j3qq4hch/kotleta/README.md

# kotleta
[3d view](https://a360.co/2SrLnso)
