j3qq4hch/kotleta/KOTLETA.brd

## EAGLE design KOTLETA.brd (2019-02-04)

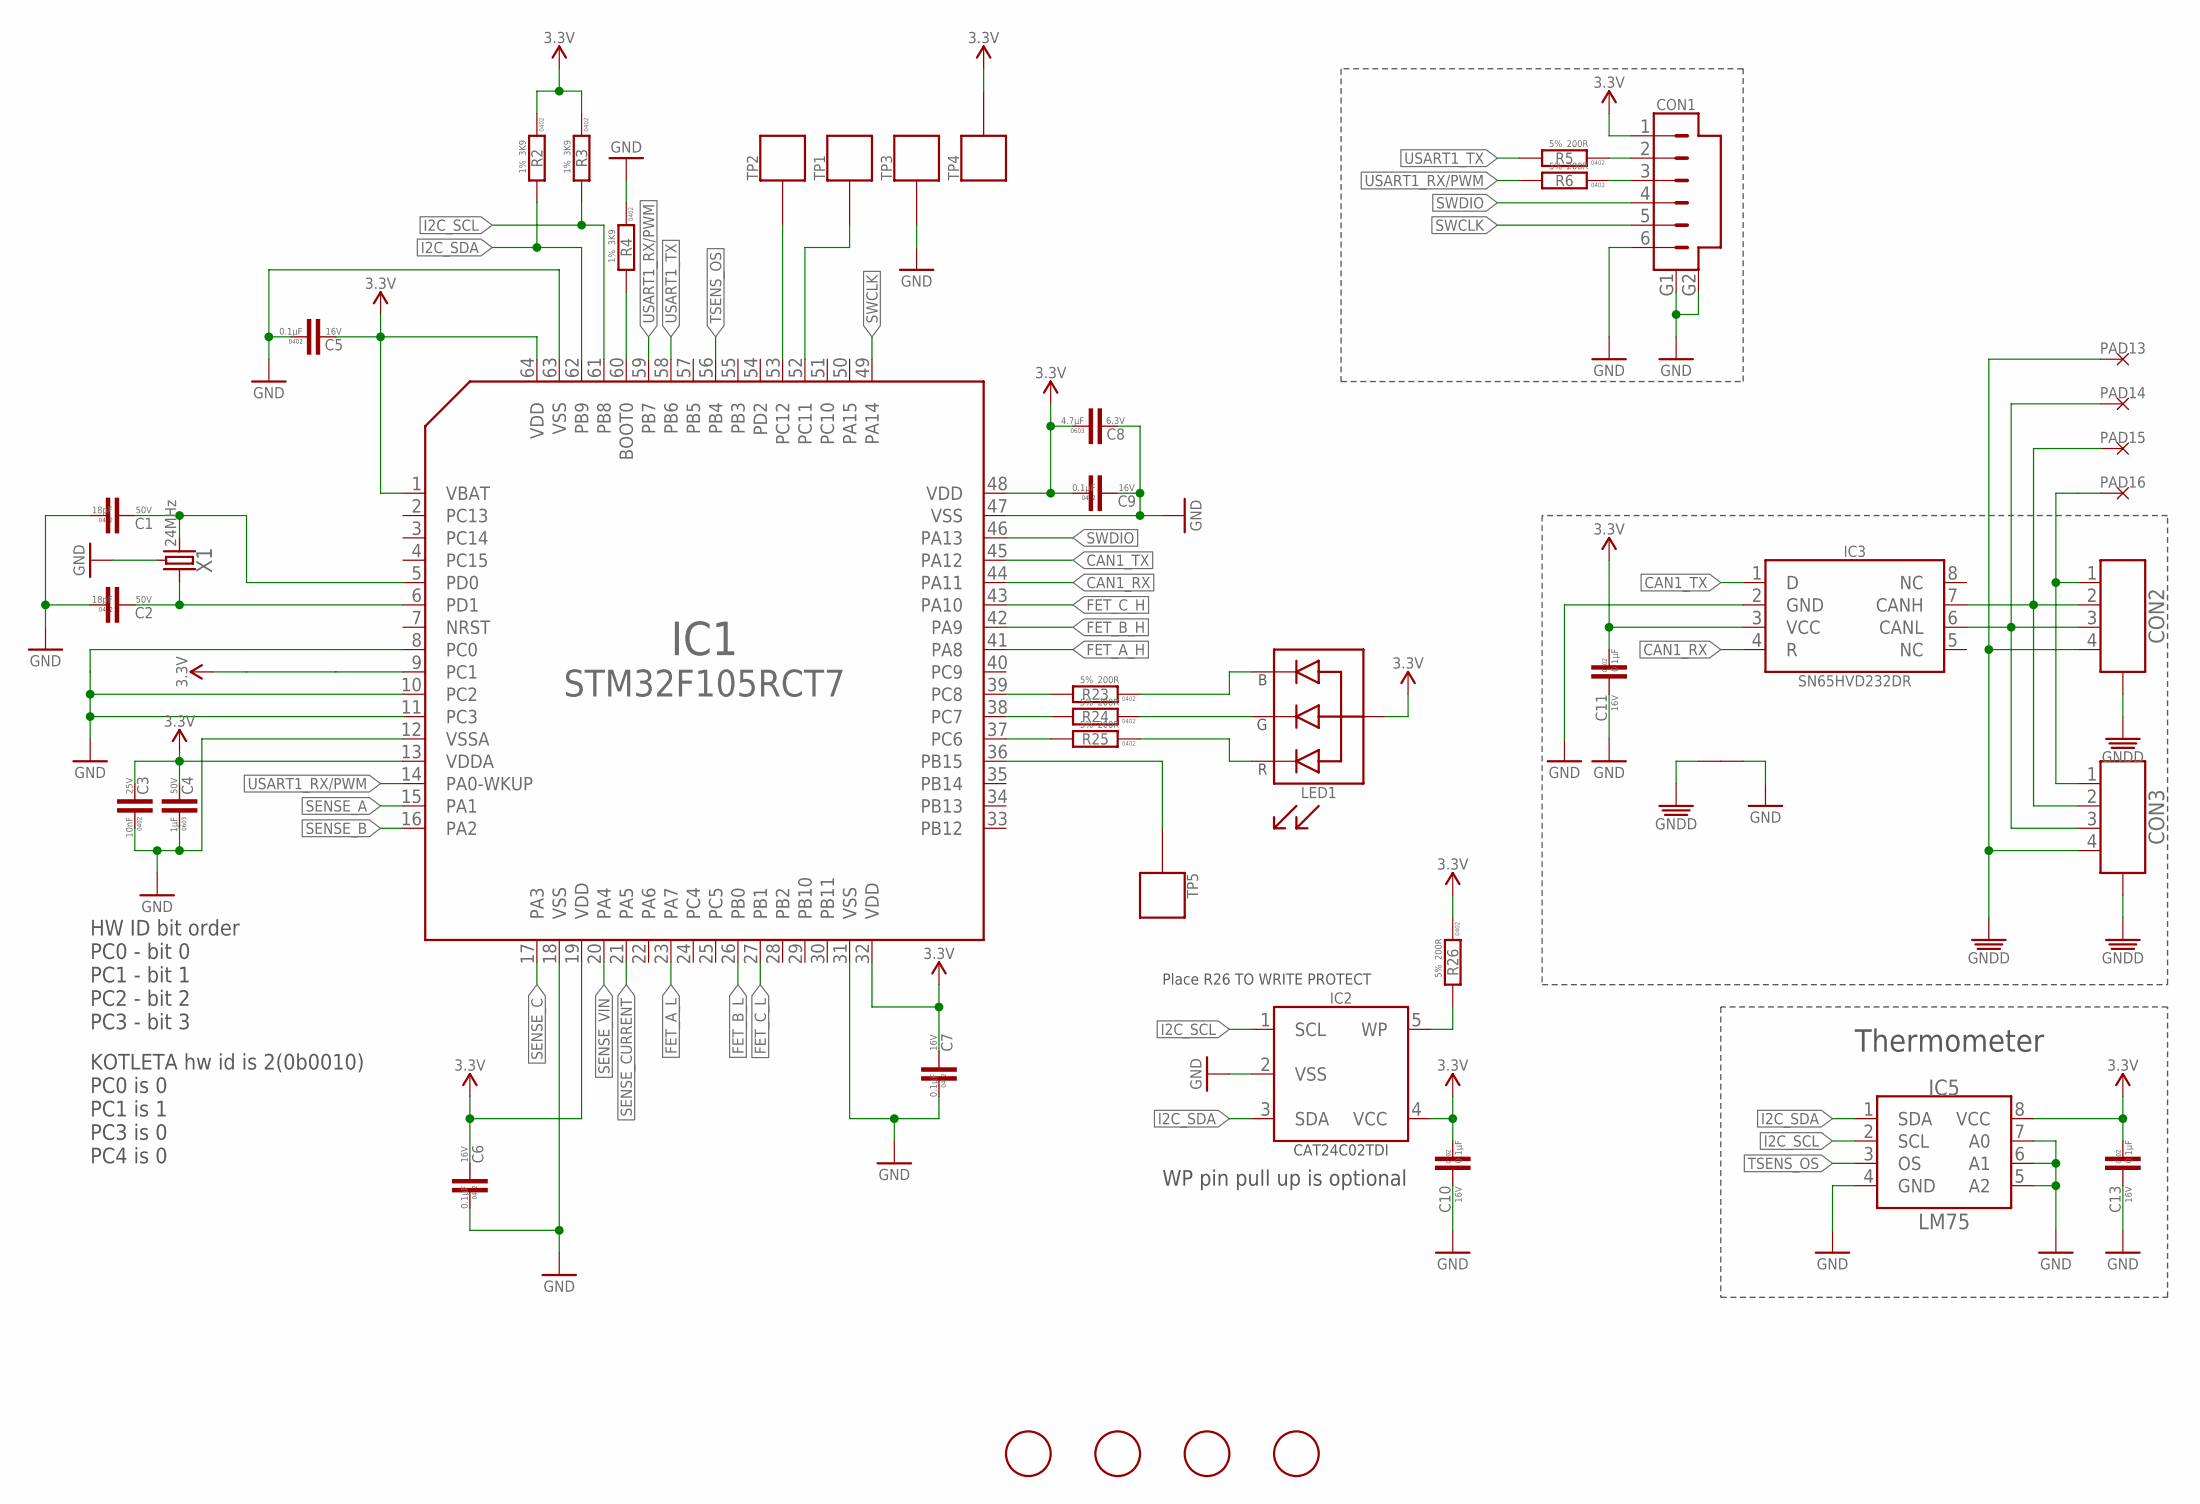
[picture p1: schematic KOTLETA.sch, sheet 1, page1]

Parts:
C1, C2: 18pF; C0402
C3: 10nF; C0402
C4: 1µF; C0603
C5, C6, C7, C9, C10, C11, C13: 0.1µF; C0402
C8: 4.7µF; C0603
CON1: CON-6P; SM06B; PARTNO SM06B-SRSS-TB
CON2, CON3: CON-4P-JST_GH-RA; JST_GH-4P-RA
FD1, FD2, FD3, FD4: FIDUCIALMOUNT; FIDUCIA-MOUNT
IC1: STM32F105RCT6; TQFP64; DIGIKEY# 497-11547-ND
IC2: CAT24C02; SOT23-5L
IC3: SN65HVD232D; SOIC8
IC5: LM75BD-TSSOP8; TSSOP8
LED1: LTST-C19HE1WT; LITE_ON_RGB_LED
PAD13, PAD14, PAD15, PAD16: PAD-HOLE-0.6; HOLE_0.6
R2, R3, R4: 3K9; R0402
R5, R6, R23, R24, R25, R26: 200R; R0402; PARTNO RC0402FR-07240RL
TP1, TP2, TP3, TP4, TP5: PAD.05; PAD.05X.05; PARTNO *
U$2: CONNECTION
X1: 24MHz; OSCILLATOR-3.2X2.5-4P; DIGIKEY# 1253-1198-1-ND

Connections:
BOOT0: IC1.60 (BOOT0), R4.2
CAN1_RX: IC1.44 (PA11), IC3.4 (R)
CAN1_TX: IC1.45 (PA12), IC3.1 (D)
FET_A_H: IC1.41 (PA8); also elsewhere on the board
FET_A_L: IC1.23 (PA7); also elsewhere on the board
FET_B_H: IC1.42 (PA9); also elsewhere on the board
FET_B_L: IC1.26 (PB0); also elsewhere on the board
FET_C_H: IC1.43 (PA10); also elsewhere on the board
FET_C_L: IC1.27 (PB1); also elsewhere on the board
GND: C1.1, C2.1, C3.1, C4.P$1 (1), C5.1, C6.1, C7.1, C8.P$2 (2), C9.2, C10.2, C11.2, C13.2, CON1.6, CON1.G1, CON1.G2, IC1.8 (PC0), IC1.10 (PC2), IC1.11 (PC3), IC1.12 (VSSA), IC1.18 (VSS), IC1.31 (VSS), IC1.47 (VSS), IC1.63 (VSS), IC2.2 (VSS), IC3.2 (GND), IC5.4 (GND), IC5.5 (A2), IC5.6 (A1), IC5.7 (A0), R4.1, TP3.P$1, U$2.P$2, X1.2 (GND), X1.4 (GND); also elsewhere on the board
GNDD: CON2.4, CON2.M$0 (GND), CON2.M$1 (GND), CON3.4, CON3.M$0 (GND), CON3.M$1 (GND), PAD13.P$1, U$2.P$1
I2C_SCL: IC1.61 (PB8), IC2.1 (SCL), IC5.2 (SCL), R3.2
I2C_SDA: IC1.62 (PB9), IC2.3 (SDA), IC5.1 (SDA), R2.2
unnamed: CON1.2, R5.1
unnamed: CON1.3, R6.1
unnamed: IC1.37 (PC6), R25.2
unnamed: LED1.B, R23.1
unnamed: LED1.R, R25.1
unnamed: IC2.5 (WP), R26.2
unnamed: IC1.38 (PC7), R24.2
unnamed: C1.2, IC1.5 (PD0), X1.3 (2)
unnamed: IC1.39 (PC8), R23.2
unnamed: C2.2, IC1.6 (PD1), X1.1
unnamed: CON2.1, CON3.1, PAD16.P$1
unnamed: CON2.2, CON3.2, IC3.7 (CANH), PAD15.P$1
unnamed: CON2.3, CON3.3, IC3.6 (CANL), PAD14.P$1
unnamed: LED1.G, R24.1
unnamed: IC1.53 (PC12), TP2.P$1
unnamed: IC1.36 (PB15), TP5.P$1
unnamed: IC1.52 (PC11), TP1.P$1
SENSE_A: IC1.15 (PA1); also elsewhere on the board
SENSE_B: IC1.16 (PA2); also elsewhere on the board
SENSE_C: IC1.17 (PA3); also elsewhere on the board
SENSE_CURRENT: IC1.21 (PA5); also elsewhere on the board
SENSE_VIN: IC1.20 (PA4); also elsewhere on the board
SWCLK: CON1.5, IC1.49 (PA14)
SWDIO: CON1.4, IC1.46 (PA13)
TSENS_OS: IC1.56 (PB4), IC5.3 (OS)
USART1_RX/PWM: IC1.14 (PA0-WKUP), IC1.59 (PB7), R6.2
USART1_TX: IC1.58 (PB6), R5.2
VDD_3V3: C3.2, C4.P$2 (2), C5.2, C6.2, C7.2, C8.P$1 (1), C9.1, C10.1, C11.1, C13.1, CON1.1, IC1.1 (VBAT), IC1.9 (PC1), IC1.13 (VDDA), IC1.19 (VDD), IC1.32 (VDD), IC1.48 (VDD), IC1.64 (VDD), IC2.4 (VCC), IC3.3 (VCC), IC5.8 (VCC), LED1.+ (A), R2.1, R3.1, R26.1, TP4.P$1; also elsewhere on the board

Notes on the sheet:
Thermometer
Place R26 TO WRITE PROTECT
WP pin pull up is optional
HW ID bit order PC0 - bit 0 PC1 - bit 1 PC2 - bit 2 PC3 - bit 3
KOTLETA hw id is 2(0b0010) PC0 is 0 PC1 is 1 PC3 is 0 PC4 is 0

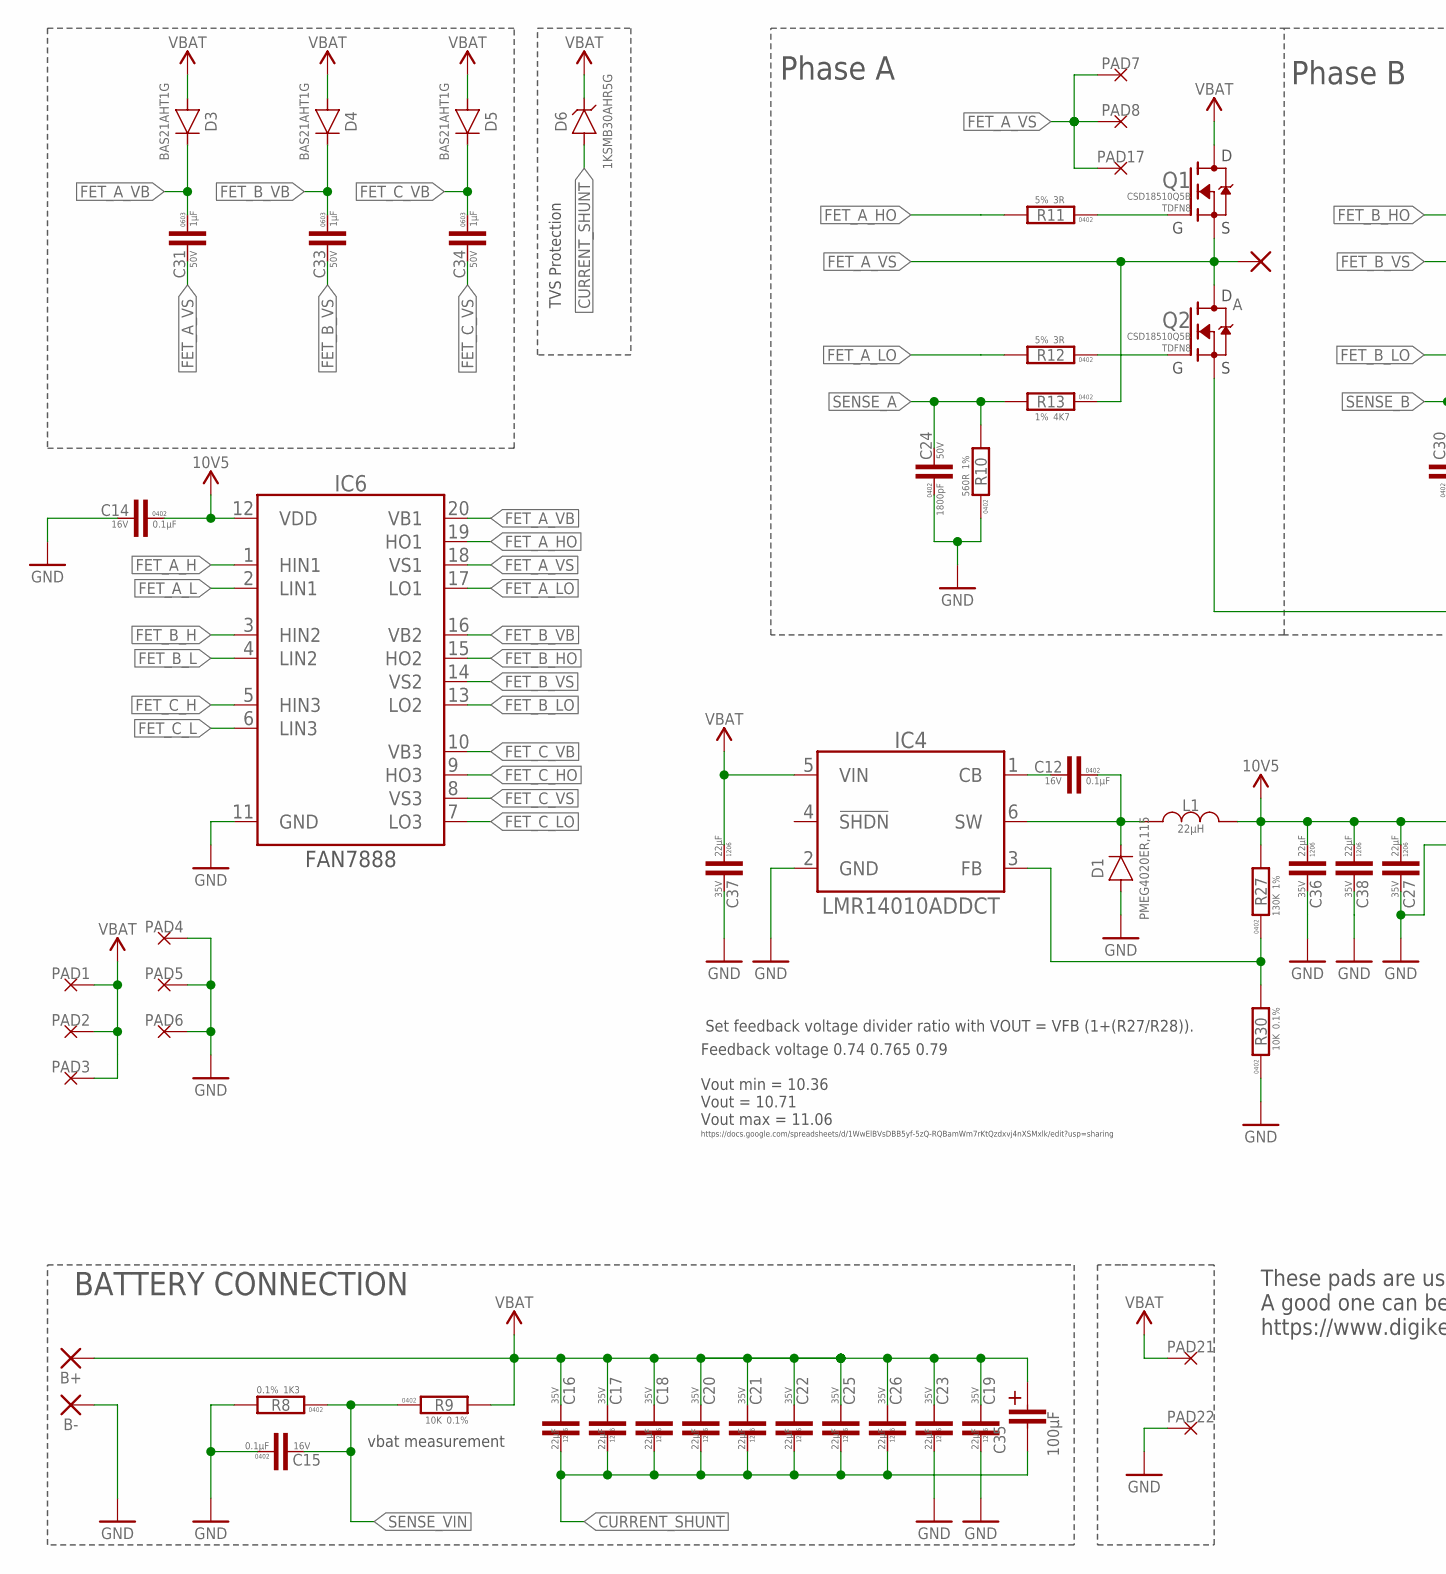
[picture p2: schematic KOTLETA.sch, sheet 2, part in row 1, column 1]

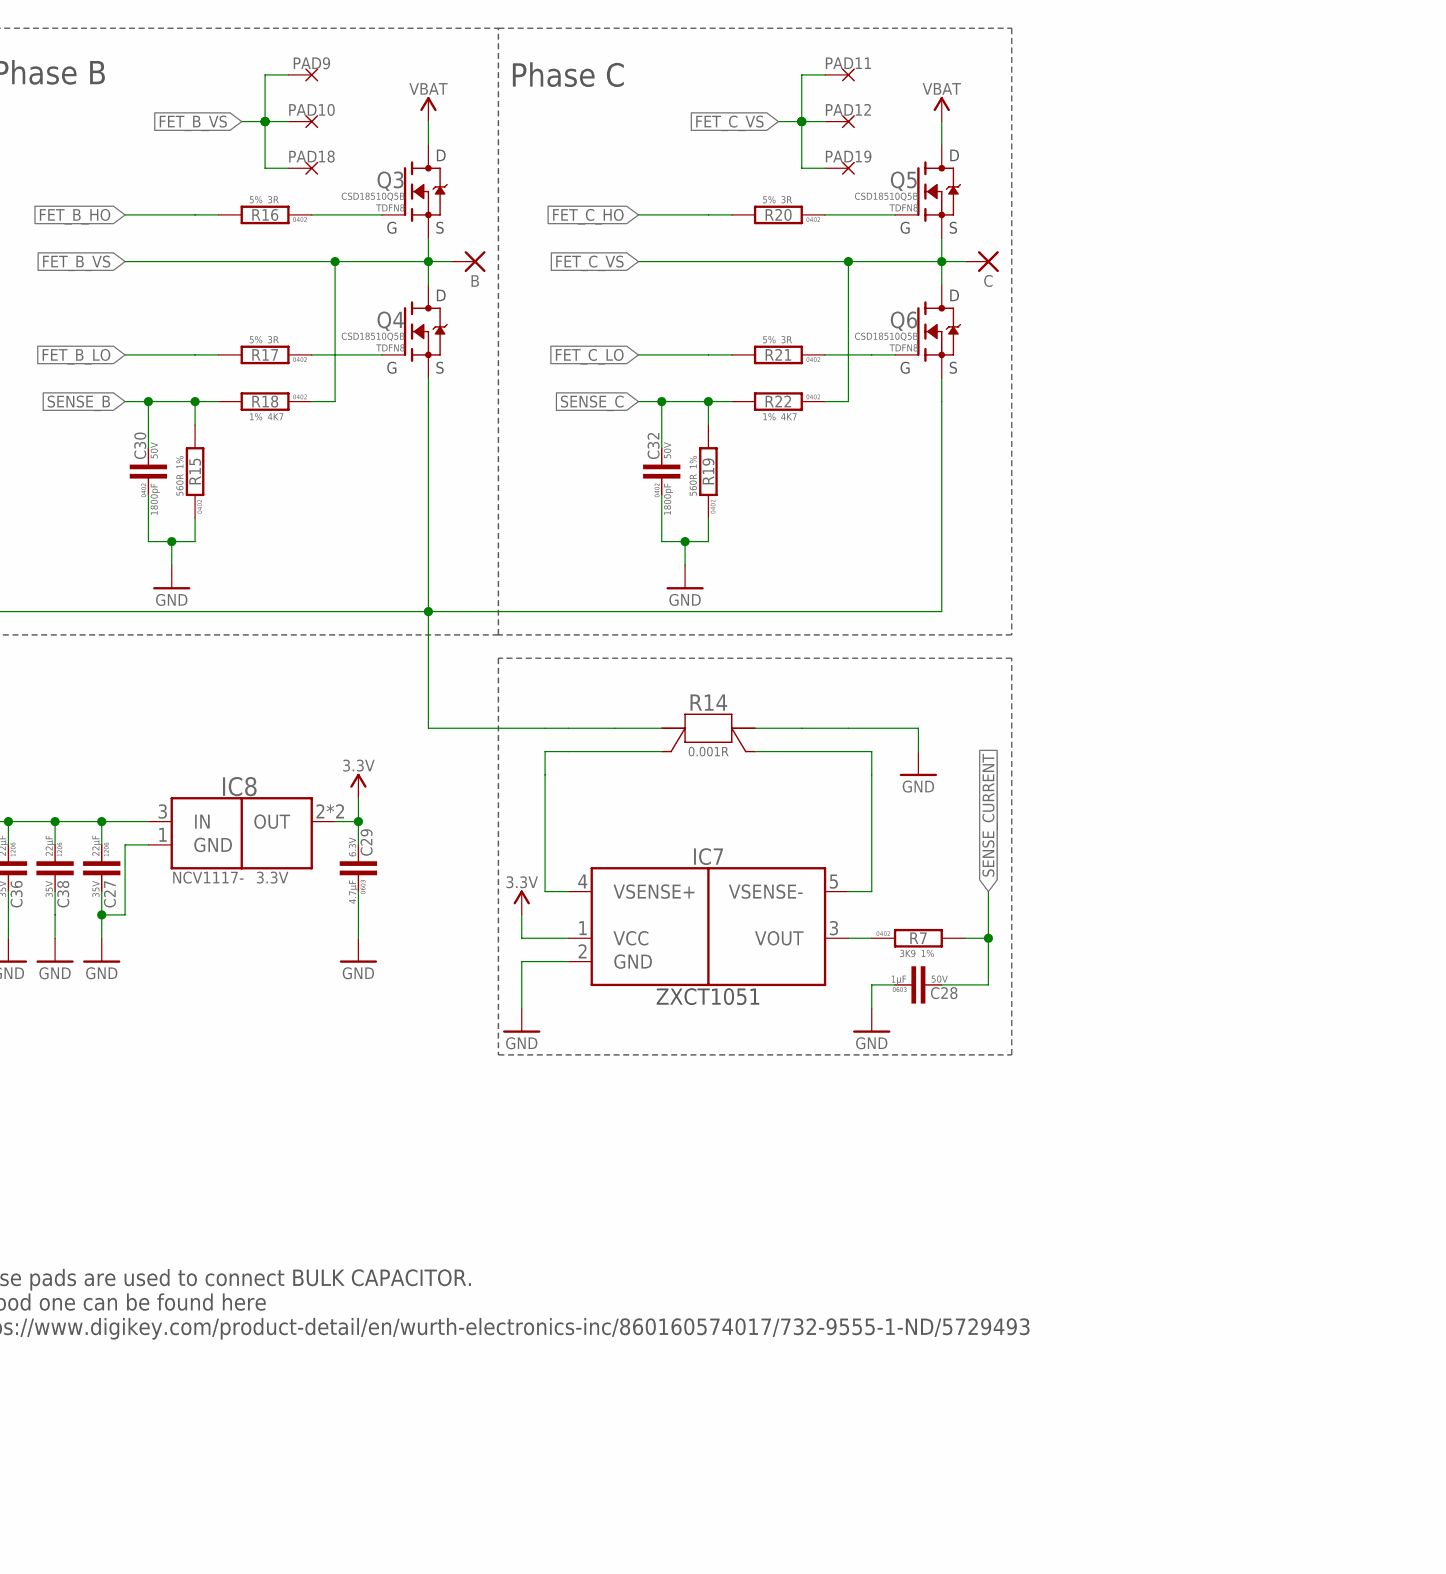
[picture p3: schematic KOTLETA.sch, sheet 2, part in row 1, column 2]

Parts:
A: WIREPADSMD5-2,5; 5-2,5
B: WIREPADSMD5-2,5; 5-2,5
B+: WIREPADSMD5-2,5; 5-2,5
B-: WIREPADSMD5-2,5; 5-2,5
C: WIREPADSMD5-2,5; 5-2,5
C12, C14, C15: 0.1µF; C0402
C16, C17, C18, C19, C20, C21, C22, C23, C25, C26, C27, C36, C37, C38: 22µF; C1206
C24, C30, C32: 1800pF; C0402
C28, C31, C33, C34: 1µF; C0603
C29: 4.7µF; C0603
C35: 100µF; 3024
D1: PMEG4020; SOD123W
D3, D4, D5: BAS21AHT1G; SOD323
D6: 1KSMB30AHR5G; DO-214AA(SMB)
IC4: LMR14010ADDCT; SOT23-6
IC6: FAN7888; SOIC20; PARTNO FAN7888MX
IC7: ZXCT1051; SOT23-5L
IC8: 3.3V; SOT-223
L1: 22µH; SRN5040
PAD1, PAD2, PAD3, PAD4, PAD5, PAD6, PAD7, PAD8, PAD9, PAD10, PAD11, PAD12, PAD17, PAD18, PAD19: PAD-HOLE-0.6; HOLE_0.6
PAD21, PAD22: PAD-HOLE-0.8; HOLE_0.8
Q1, Q2, Q3, Q4, Q5, Q6: CSD18510Q5B; PG-TDSON-8
R7: 3K9; R0402
R8: 1K3; R0402
R9, R30: 10K; R0402
R10, R15, R19: 560R; R0402
R11, R12, R16, R17, R20, R21: 3R; R0402
R13, R18, R22: 4K7; R0402
R14: 0.001R; R2010-KELVIN
R27: 130K; R0402; DIGIKEY# YAG2969CT-ND

Connections:
BLABLA: IC7.3 (VOUT), R7.1
CURRENT_SHUNT: C16.P$1 (1), C17.P$1 (1), C18.P$1 (1), C20.P$1 (1), C21.P$1 (1), C22.P$1 (1), C25.P$1 (1), C26.P$1 (1), C35.-, D6.A, Q2.1S (S), Q2.2S (S), Q2.3S (S), Q4.1S (S), Q4.2S (S), Q4.3S (S), Q6.1S (S), Q6.2S (S), Q6.3S (S), R14.1, R14.11 (1)
FET_A_H: IC6.1 (HIN1); also elsewhere on the board
FET_A_HO: IC6.19 (HO1), R11.2
FET_A_L: IC6.2 (LIN1); also elsewhere on the board
FET_A_LO: IC6.17 (LO1), R12.2
FET_A_VB: C31.P$1 (1), D3.C, IC6.20 (VB1)
FET_A_VS: A.1, C31.P$2 (2), IC6.18 (VS1), PAD7.P$1, PAD8.P$1, PAD17.P$1, Q1.1S (S), Q1.2S (S), Q1.3S (S), Q2.5D (D), Q2.6D (D), Q2.7D (D), Q2.8D (D), Q2.PAD_D (D), R13.1
FET_B_H: IC6.3 (HIN2); also elsewhere on the board
FET_B_HO: IC6.15 (HO2), R16.2
FET_B_L: IC6.4 (LIN2); also elsewhere on the board
FET_B_LO: IC6.13 (LO2), R17.2
FET_B_VB: C33.P$1 (1), D4.C, IC6.16 (VB2)
FET_B_VS: B.1, C33.P$2 (2), IC6.14 (VS2), PAD9.P$1, PAD10.P$1, PAD18.P$1, Q3.1S (S), Q3.2S (S), Q3.3S (S), Q4.5D (D), Q4.6D (D), Q4.7D (D), Q4.8D (D), Q4.PAD_D (D), R18.1
FET_C_H: IC6.5 (HIN3); also elsewhere on the board
FET_C_HO: IC6.9 (HO3), R20.2
FET_C_L: IC6.6 (LIN3); also elsewhere on the board
FET_C_LO: IC6.7 (LO3), R21.2
FET_C_VB: C34.P$1 (1), D5.C, IC6.10 (VB3)
FET_C_VS: C.1, C34.P$2 (2), IC6.8 (VS3), PAD11.P$1, PAD12.P$1, PAD19.P$1, Q5.1S (S), Q5.2S (S), Q5.3S (S), Q6.5D (D), Q6.6D (D), Q6.7D (D), Q6.8D (D), Q6.PAD_D (D), R22.1
GND: B-.1, C14.2, C15.1, C19.P$1 (1), C23.P$1 (1), C24.1, C27.P$2 (2), C28.P$1 (1), C29.P$1 (1), C30.1, C32.1, C36.P$2 (2), C37.P$2 (2), C38.P$2 (2), D1.A, IC4.2 (GND), IC6.11 (GND), IC7.2 (GND), IC8.1 (GND), PAD4.P$1, PAD5.P$1, PAD6.P$1, PAD22.P$1, R8.2, R10.1, R14.2, R14.22 (2), R15.1, R19.1, R30.1; also elsewhere on the board
unnamed: Q2.4G (G), R12.1
unnamed: Q3.4G (G), R16.1
unnamed: Q4.4G (G), R17.1
unnamed: Q5.4G (G), R20.1
unnamed: IC7.5 (VSENSE-), R14.S2
unnamed: Q1.4G (G), R11.1
unnamed: Q6.4G (G), R21.1
unnamed: C12.1, D1.C, IC4.6 (SW), L1.P$1
unnamed: IC7.4 (VSENSE+), R14.S1
unnamed: IC4.3 (FB), R27.1, R30.2
unnamed: C12.2, IC4.1 (CB)
SENSE_A: C24.2, R10.2, R13.2; also elsewhere on the board
SENSE_B: C30.2, R15.2, R18.2; also elsewhere on the board
SENSE_C: C32.2, R19.2, R22.2; also elsewhere on the board
SENSE_CURRENT: C28.P$2 (2), R7.2; also elsewhere on the board
SENSE_VIN: C15.2, R8.1, R9.1; also elsewhere on the board
VBAT: B+.1, C16.P$2 (2), C17.P$2 (2), C18.P$2 (2), C19.P$2 (2), C20.P$2 (2), C21.P$2 (2), C22.P$2 (2), C23.P$2 (2), C25.P$2 (2), C26.P$2 (2), C35.+, C37.P$1 (1), D3.A, D4.A, D5.A, D6.C, IC4.5 (VIN), PAD1.P$1, PAD2.P$1, PAD3.P$1, PAD21.P$1, Q1.5D (D), Q1.6D (D), Q1.7D (D), Q1.8D (D), Q1.PAD_D (D), Q3.5D (D), Q3.6D (D), Q3.7D (D), Q3.8D (D), Q3.PAD_D (D), Q5.5D (D), Q5.6D (D), Q5.7D (D), Q5.8D (D), Q5.PAD_D (D), R9.2
VDD_3V3: C29.P$2 (2), IC7.1 (VCC), IC8.2 (OUT), IC8.4 (OUT); also elsewhere on the board
VDD_10V5: C14.1, C27.P$1 (1), C36.P$1 (1), C38.P$1 (1), IC6.12 (VDD), IC8.3 (IN), L1.P$2, R27.2

Notes on the sheet:
vbat measurement
BATTERY CONNECTION
Phase A
Phase B
Phase C
TVS Protection
Set feedback voltage divider ratio with VOUT = VFB (1+(R27/R28)).
Feedback voltage 0.74 0.765 0.79
Vout min = 10.36 Vout = 10.71 Vout max = 11.06
https://docs.google.com/spreadsheets/d/1WwElBVsDBB5yf-5zQ-RQBamWm7rKtQzdxvj4nXSMxlk/edit?usp=sharing
These pads are used to connect BULK CAPACITOR. A good one can be found here https://www.digikey.com/product-detail/en/wurth-electronics-inc/860160574017/732-9555-1-ND/5729493

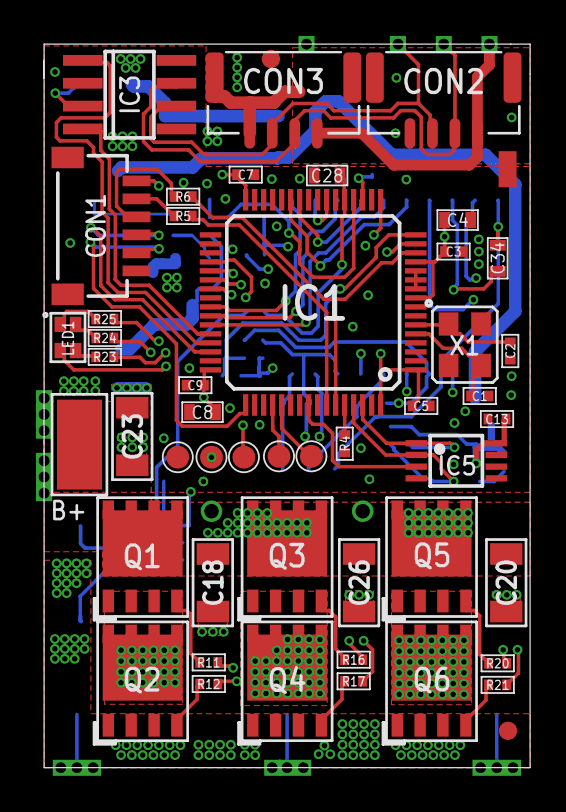
[picture p4: board KOTLETA.brd from above]

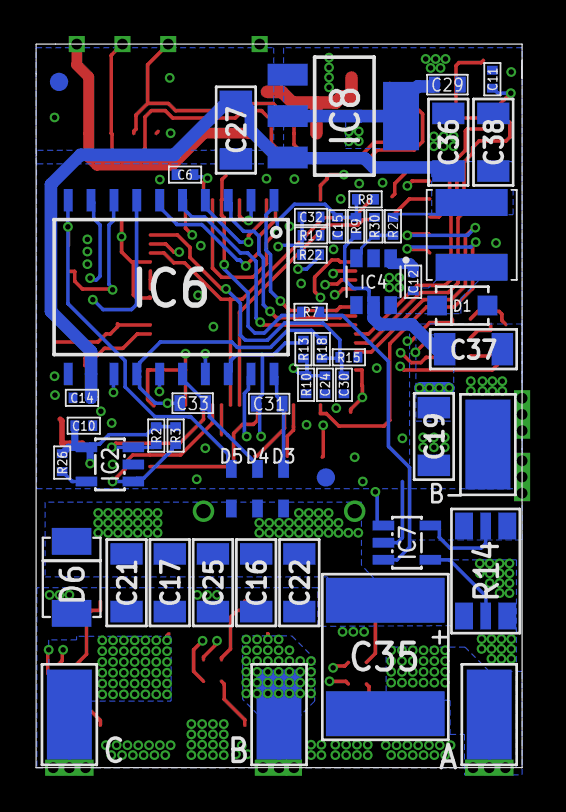
[picture p5: board KOTLETA.brd from below]

Board: 4 copper layers, 27.0 x 40.2 mm, 126 parts (64 on the bottom side), 68 nets.
