j3qq4hch/kotleta/(commit log)

2019-02-03 initial import
    [KOTLETA.brd, KOTLETA.sch]
2019-02-03 proper gitignore
    [KOTLETA.brd, KOTLETA.sch]
2019-02-03 routing done
    [KOTLETA.brd, KOTLETA.sch]
2019-02-03 BETTER polygons
    [KOTLETA.brd]
2019-02-03 minor fixes
    [KOTLETA.brd]
2019-02-03 BOM fixes
    [KOTLETA.brd, KOTLETA.sch]
2019-02-03 proper assembly variant
    [KOTLETA.brd, KOTLETA.sch]
2019-02-03 BOM updates
    [KOTLETA.brd, KOTLETA.sch]
2019-02-03 Its 10V5 noew. HW ID stuff also fixed
    [KOTLETA.brd, KOTLETA.sch]
2019-02-03 pads for bulk capacitor
    [KOTLETA.brd, KOTLETA.sch]
2019-02-04 minor updates
    [KOTLETA.brd, KOTLETA.sch]
2019-02-04 DRC updates
    [KOTLETA.brd]
